DavidRichardson02/FPGA_Signal_Control_System/docs/PIPE@CECS Showcase Poster Template (24x36) FPGA_Signal_Control_System.pptx

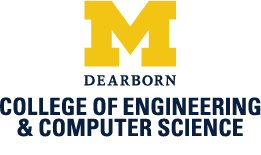
[picture p1: figure]

Promoting Innovation in
Project-Based Education–PIPE
PIPEline to Curiosity, Connections, and Creating value

FPGA Signal Control System

Student: David Richardson
Course: ECE-375 Introduction to Computer Architecture

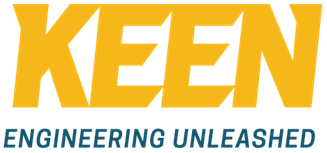
[picture p2: figure]

Faculty : Professor Furat-Al-Obaidy

System Overview

FPGA platform: Digilent Nexys A7-100T (Artix-7, 100 MHz system clock).
Major subsystems:
ToF range acquisition
I²C master talking to an ISL29501 Pmod ToF sensor.
Q1.15 polar angle encoder and millimeter distance samples.
Ready/valid streaming into the packetizer and UART.
Temperature sensing & fan control
XADC channel monitors board temperature (converted to Q1.15).
Occupancy via PIR sensor; manual override via slide switches.
PWM duty-based fan drive using external MOSFET and 5 V fan.
Visualization & logging
640×480@60 Hz VGA: ToF spatial plot + telemetry panel.
2 Mbit/s UART: binary frames logged by a WaveForms script.
On-board 7-segment clock summarizing FPGA uptime.

Motivation & Objectives

This project implements an integrated real-time measurement and control system on a Nexys A7-100T FPGA board. The goals are:
i. Build a fully synchronous, single-clock-domain FPGA design that exercises the full toolchain: HDL, constraints, synthesis, implementation, and hardware bring-up.
ii. Perform dynamic spatial mapping using a Time-of-Flight (ToF) distance sensor swept over angle, and stream samples to both a VGA display and a PC.
iii. Implement closed-loop temperature-based cooling using a brushless DC fan, with PIR-based occupancy logic and manual override.
iv. Develop rich telemetry—UART streaming and VGA overlays—to make internal FPGA state visible on the bench in real time.

Architecture & Spatial Mapping

The design forms a closed experimentation loop from HDL to bench measurements and data analysis:

Control Logic: Cooling & Occupancy

The control logic layer ties sensing and actuation together:
i. Gathers inputs from the ToF sampler, XADC temperature monitor, PIR occupancy detector, and mode switches (TEMP / MAN / PIR).
ii. Runs a sweep state machine that steps the ToF angle, tags each distance sample with a Q1.15 heading, and asserts sweep_wrap at the end of each scan.
iii. Implements a temperature-based fan controller with hysteresis and occupancy extension: PIR activity can hold the fan on longer in occupied intervals, while switches gate each control path.
iv. Forms a global fan decision (fan_on) that drives the PWM duty cycle and is mirrored into the VGA tiles and UART telemetry.
v. Separating this control path from the ToF data path makes it easier to reason about safety, priorities, and future extensions.

Dynamic Spatial Mapping Pipeline

i. ToF sampling: The I²C master periodically reads a 16-bit distance register from the Pmod ToF sensor.
ii. Angle tagging: A Q1.15 angle accumulator advances with each step of the sweep state machine, providing a fractional-turn angle θ ∈ [−0.5, 0.5).
iii. Polar-to-framebuffer mapping:
Distance is scaled into a radius within 0 mm to Rmax.
Angle selects an x index; radius selects a y index in a 256×256 bit-plane.
i. Framebuffer accumulation:
A dual-port BRAM acts as a hit map for ToF samples.
One port writes in the 100 MHz domain; the other reads in the 25 MHz pixel domain.
A frame-clear FSM wipes the BRAM once per sweep.
i. UART packetization:
Each sample is packed into a 0x55 0xAA-framed UART packet.
Payload includes timestamp, θ_q15, distance, and status.
A PC-side WaveForms script decodes frames and logs CSV.

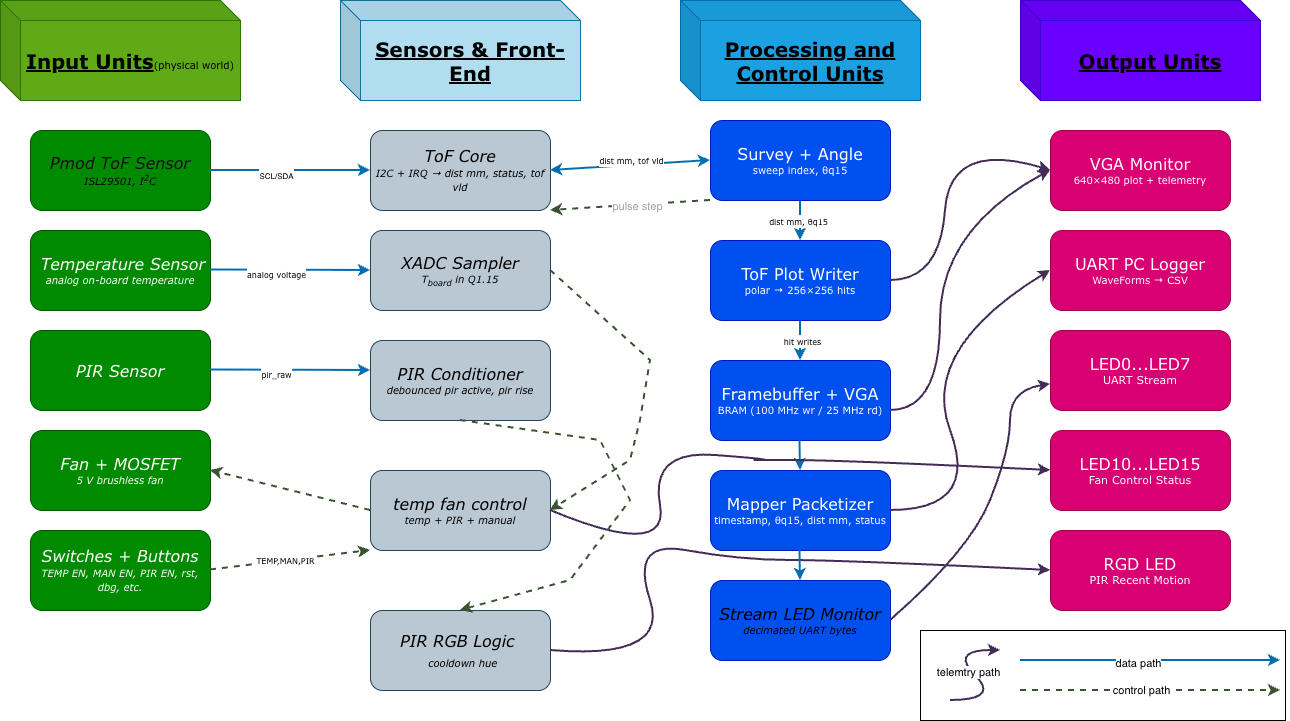
[picture p3: figure]

Hardware Bench Setup

Nexys A7-100T FPGA board with VGA, UART, and Pmod headers.
Breadboard hosting:
i. ToF Pmod (I2C)
ii. PIR sensor
iii. N-channel MOSFET fan driver and 5 V fan
iv. RGB LED with current-limiting resistors
Digilent Analog Discovery 2:
i. Scope probes on PWM, UART, and supply rails
ii. Wavegen for stimulus tests and synchronous analog experiments
iii. Protocol instrument for I²C and UART debugging

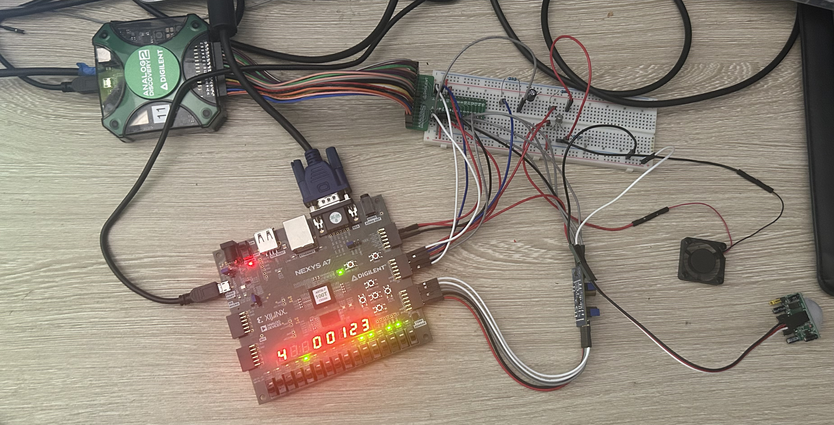
[picture p4: figure]

Key Results

Real-time visualization:
i. Stable 640x480 VGA output with combined ToF plot and telemetry panel.
ii. Fan activity, occupancy state, and UART bytes are all visible directly on-screen.
Robust concurrency:
i. ToF sampling, UART streaming, VGA refresh, and cooling control all run concurrently without explicit CPUs or soft-cores.
ii. Careful clock-domain crossing and ready/valid interfaces prevent metastability and data loss.
Closed-loop cooling:
i. Fan duty cycle tracks measured temperature, with PIR extending cooldown in occupied intervals.
ii. Switch-based gating allows safe experimentation with each control law.
Instrumentation-driven design:
i. WaveForms custom math scripts decode UART packets into engineering units for debugging and analysis.
ii. The analog instrumentation loop directly informed clocking, decoupling, and duty-cycle choices.

VGA Telemetry Panel

Display layout (640×480):
Left half (0–319): 256×256 ToF hit map, vertically centered, with dim background and bright green hits.
Right panel (320–639):
  i. Temperature bar derived from a calibrated Q1.15 temperature estimate.
  ii. Four fan tiles: TEMP, MAN, PIR, FAN, with color-coded enable/active states.
  iii. UART visualization row: 8-bit tile strip rendering the last transmitted byte.
  iv. Tiny 8×8 pixel font for tick labels (e.g., 60 °F, 75 °F, 90 °F) and fan tile captions.
Technical highlights
i. 25 MHz pixel clock derived from the 100 MHz fabric clock via divide-by-4.
ii. Fully synchronous colorizer: per-pixel combinational logic chooses between plot, temperature bar, fan tiles, UART tiles, and background.
iii. Minimal cross-domain complexity: slow telemetry signals are resynchronized into the pixel clock domain using two-flop synchronizers.

Lessons Learned & Contributions

Lessons learned
i. Tight integration of FPGA logic with rich instrumentation (AD2, UART, VGA) dramatically shortens debug cycles.
ii. Separating the data path (ToF samples, telemetry) from the control path (fan logic, switches, PIR) makes the design scalable.
iii. Thinking in Q-format fixed-point arithmetic (Q1.15) simplifies sharing values between HDL, C, and MATLAB.
Contributions
i. Unified multiple sensing and actuation modalities in a single, fully synchronous FPGA design.
ii. Built a reusable Verilog library: XADC sampler, I²C + ToF core, fan controller, packetizer, UART Tx, and LED/telemetry modules.
iii. Developed an end-to-end instrumentation workflow integrating WaveForms and MATLAB with the FPGA data path.

PIPE at CECS 2025
