DavidRichardson02/FPGA_Signal_Control_System/RTL/font8x8_basic.v

`timescale 1ns/1ps

// ============================================================================
// Module : font8x8_basic
// Role   : Tiny 8x8 monochrome font ROM for a small ASCII subset.
//          row_bits[7] is the LEFT-most pixel in the row.
// Notes  : Glyphs are drawn mostly on rows 1..6 (row 0/7 blank) for readability.
// ============================================================================

module font8x8_basic (
    input  wire [7:0] char_code, // ASCII code
    input  wire [2:0] row,        // 0..7 (top..bottom)
    output reg  [7:0] row_bits    // bit[7]=leftmost, bit[0]=rightmost
);

always @* begin
    row_bits = 8'b0000_0000;

    case (char_code)

    // ------------------------------------------------------------------------
    // Digits
    // ------------------------------------------------------------------------
    "0": begin
        case (row)
        3'd1: row_bits = 8'b0011_1100;
        3'd2: row_bits = 8'b0100_0010;
        3'd3: row_bits = 8'b0100_0010;
        3'd4: row_bits = 8'b0100_0010;
        3'd5: row_bits = 8'b0100_0010;
        3'd6: row_bits = 8'b0011_1100;
        default: ;
        endcase
    end

    "1": begin
        case (row)
        3'd1: row_bits = 8'b0001_1000;
        3'd2: row_bits = 8'b0010_1000;
        3'd3: row_bits = 8'b0000_1000;
        3'd4: row_bits = 8'b0000_1000;
        3'd5: row_bits = 8'b0000_1000;
        3'd6: row_bits = 8'b0011_1110;
        default: ;
        endcase
    end

    "2": begin
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
        3'd4: row_bits = 8'b0001_0000;
        3'd5: row_bits = 8'b0010_0000;
        3'd6: row_bits = 8'b0111_1110;
        default: ;
        endcase
    end

    default: begin
        // unimplemented -> blank
        row_bits = 8'b0000_0000;
    end
    endcase
end

endmodule
