DavidRichardson02/FPGA_Signal_Control_System/(commit log)

2025-12-25 Enhance README with system architecture flowchart
    Added flowchart detailing the system architecture and stages of processing.
2025-12-25 Revise flowchart and project stages in README
    Updated flowchart sections in the README to reflect changes in physical inputs, sensing, acquisition, state estimation, control, telemetry, and analysis stages.
2025-12-25 Replace flowchart with SVG block diagram
    Removed flowchart and added SVG block diagram for FPGA Signal Control System.
